datvo10-design/Single-Cycle-Pipelined-RISC-V-Processor/README.md

# Single-Cycle-Pipelined-RISC-V-Processor
Single-Cycle &amp; Pipelined RISC-V Processor
