datvo10-design/Single-Cycle-Pipelined-RISC-V-Processor/(list of files, drawings)

Other design files:
03_sim/wave.dsn
