datvo10-design/Single-Cycle-Pipelined-RISC-V-Processor/00_src/primitive/sll_32bit.sv

// --- Module chính: Bộ dịch trái 32-bit bằng cách ghép 32 con mux 32-1 1bit với nhau ---
module sll_32bit (
    input  logic [31:0] Y,		// dữ liệu 32 bit đưa vào
    input  logic [4:0] S,		// tín hiệu điều khiển, ví dụ S = sel = 00000 thì ngõ vào dữ liệu là d0
    output logic [31:0] Z		// dữ liệu 32 bit ra
);
		// Bắt đầu nối chân cho 32 con MUX
		// 1. MUX cho bit Z31: đây là trường hợp chưa dịch bit nào (Inputs: Y31, Y32,...Y1, Y0: tổng 32 ngõ vào
		mux_32_to_1 u_mux_for_Z32 (.d0(Y[31]), .d1(Y[30]), .d2(Y[29]), .d3(Y[28]), .d4(Y[27]), .d5(Y[26]), .d6(Y[25]), .d7(Y[24]),
                         .d8(Y[23]), .d9(Y[22]), .d10(Y[21]), .d11(Y[20]), .d12(Y[19]), .d13(Y[18]), .d14(Y[17]), .d15(Y[16]),
                         .d16(Y[15]), .d17(Y[14]), .d18(Y[13]), .d19(Y[12]), .d20(Y[11]), .d21(Y[10]), .d22(Y[9]), .d23(Y[8]),
                         .d24(Y[7]), .d25(Y[6]), .d26(Y[5]), .d27(Y[4]), .d28(Y[3]), .d29(Y[2]), .d30(Y[1]), .d31(Y[0]), .sel(S), .Z(Z[31]));
								 
		// 2. MUX cho bit Z30 (Inputs: Y30, Y29, ..., Y0, 0)
		mux_32_to_1 u_mux_for_Z30 (.d0(Y[30]), .d1(Y[29]), .d2(Y[28]), .d3(Y[27]), .d4(Y[26]), .d5(Y[25]), .d6(Y[24]), .d7(Y[23]),
                         .d8(Y[22]), .d9(Y[21]), .d10(Y[20]), .d11(Y[19]), .d12(Y[18]), .d13(Y[17]), .d14(Y[16]), .d15(Y[15]),
                         .d16(Y[14]), .d17(Y[13]), .d18(Y[12]), .d19(Y[11]), .d20(Y[10]), .d21(Y[9]),  .d22(Y[8]),  .d23(Y[7]),
                         .d24(Y[6]),  .d25(Y[5]),  .d26(Y[4]),  .d27(Y[3]),  .d28(Y[2]),  .d29(Y[1]),  .d30(Y[0]),  .d31(1'b0), .sel(S), .Z(Z[30]));	

		// 3. MUX cho bit Z29
		mux_32_to_1 u_mux_for_Z29 (.d0(Y[29]), .d1(Y[28]), .d2(Y[27]), .d3(Y[26]), .d4(Y[25]), .d5(Y[24]), .d6(Y[23]), .d7(Y[22]),
                         .d8(Y[21]), .d9(Y[20]), .d10(Y[19]), .d11(Y[18]), .d12(Y[17]), .d13(Y[16]), .d14(Y[15]), .d15(Y[14]),
                         .d16(Y[13]), .d17(Y[12]), .d18(Y[11]), .d19(Y[10]), .d20(Y[9]),  .d21(Y[8]),  .d22(Y[7]),  .d23(Y[6]),
                         .d24(Y[5]),  .d25(Y[4]),  .d26(Y[3]),  .d27(Y[2]),  .d28(Y[1]),  .d29(Y[0]),  .d30(1'b0), .d31(1'b0), .sel(S), .Z(Z[29]));

		// 4. MUX cho bit Z28
		mux_32_to_1 u_mux_for_Z28 (.d0(Y[28]), .d1(Y[27]), .d2(Y[26]), .d3(Y[25]), .d4(Y[24]), .d5(Y[23]), .d6(Y[22]), .d7(Y[21]),
                         .d8(Y[20]), .d9(Y[19]), .d10(Y[18]), .d11(Y[17]), .d12(Y[16]), .d13(Y[15]), .d14(Y[14]), .d15(Y[13]),
                         .d16(Y[12]), .d17(Y[11]), .d18(Y[10]), .d19(Y[9]),  .d20(Y[8]),  .d21(Y[7]),  .d22(Y[6]),  .d23(Y[5]),
                         .d24(Y[4]),  .d25(Y[3]),  .d26(Y[2]),  .d27(Y[1]),  .d28(Y[0]),  .d29(1'b0), .d30(1'b0), .d31(1'b0), .sel(S), .Z(Z[28]));

		// 5. MUX cho bit Z27
		mux_32_to_1 u_mux_for_Z27 (.d0(Y[27]), .d1(Y[26]), .d2(Y[25]), .d3(Y[24]), .d4(Y[23]), .d5(Y[22]), .d6(Y[21]), .d7(Y[20]),
                         .d8(Y[19]), .d9(Y[18]), .d10(Y[17]), .d11(Y[16]), .d12(Y[15]), .d13(Y[14]), .d14(Y[13]), .d15(Y[12]),
                         .d16(Y[11]), .d17(Y[10]), .d18(Y[9]),  .d19(Y[8]),  .d20(Y[7]),  .d21(Y[6]),  .d22(Y[5]),  .d23(Y[4]),
                         .d24(Y[3]),  .d25(Y[2]),  .d26(Y[1]),  .d27(Y[0]),  .d28(1'b0), .d29(1'b0), .d30(1'b0), .d31(1'b0), .sel(S), .Z(Z[27]));

		// 6. MUX cho bit Z26
		mux_32_to_1 u_mux_for_Z26 (.d0(Y[26]), .d1(Y[25]), .d2(Y[24]), .d3(Y[23]), .d4(Y[22]), .d5(Y[21]), .d6(Y[20]), .d7(Y[19]),
                         .d8(Y[18]), .d9(Y[17]), .d10(Y[16]), .d11(Y[15]), .d12(Y[14]), .d13(Y[13]), .d14(Y[12]), .d15(Y[11]),
                         .d16(Y[10]), .d17(Y[9]),  .d18(Y[8]),  .d19(Y[7]),  .d20(Y[6]),  .d21(Y[5]),  .d22(Y[4]),  .d23(Y[3]),
                         .d24(Y[2]),  .d25(Y[1]),  .d26(Y[0]),  .d27(1'b0), .d28(1'b0), .d29(1'b0), .d30(1'b0), .d31(1'b0), .sel(S), .Z(Z[26]));

		// 7. MUX cho bit Z25
		mux_32_to_1 u_mux_for_Z25 (.d0(Y[25]), .d1(Y[24]), .d2(Y[23]), .d3(Y[22]), .d4(Y[21]), .d5(Y[20]), .d6(Y[19]), .d7(Y[18]),
                         .d8(Y[17]), .d9(Y[16]), .d10(Y[15]), .d11(Y[14]), .d12(Y[13]), .d13(Y[12]), .d14(Y[11]), .d15(Y[10]),
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
                         .d16(1'b0), .d17(1'b0), .d18(1'b0), .d19(1'b0), .d20(1'b0), .d21(1'b0), .d22(1'b0), .d23(1'b0),
                         .d24(1'b0), .d25(1'b0), .d26(1'b0), .d27(1'b0), .d28(1'b0), .d29(1'b0), .d30(1'b0), .d31(1'b0), .sel(S), .Z(Z[0]));
		
endmodule
