datvo10-design/Single-Cycle-Pipelined-RISC-V-Processor/00_src/primitive/sra_32bit.sv

// --- Module chính: Bộ dịch phải 32-bit bằng cách ghép 32 con mux 32-1 1bit với nhau ---
module sra_32bit (
    input  logic [31:0] Y,		// dữ liệu 32 bit đưa vào
    input  logic [4:0] S,		// tín hiệu điều khiển, ví dụ S = sel = 00000 thì ngõ vào dữ liệu là d0
    output logic [31:0] Z		// dữ liệu 32 bit ra
);
		// Bắt đầu nối chân cho 32 con MUX
		// 1. MUX cho bit Z31 (Inputs: Y31, Y31, Y31,...Y31): tổng 32 ngõ vào
		mux_32_to_1 u_mux_for_Z32 (.d0(Y[31]), .d1(Y[31]), .d2(Y[31]), .d3(Y[31]), .d4(Y[31]), .d5(Y[31]), .d6(Y[31]), .d7(Y[31]), .d8(Y[31]), 
						.d9(Y[31]), .d10(Y[31]), .d11(Y[31]), .d12(Y[31]), .d13(Y[31]), .d14(Y[31]), .d15(Y[31]), .d16(Y[31]), 
						.d17(Y[31]), .d18(Y[31]), .d19(Y[31]), .d20(Y[31]), .d21(Y[31]), .d22(Y[31]), .d23(Y[31]), .d24(Y[31]),
						.d25(Y[31]), .d26(Y[31]), .d27(Y[31]), .d28(Y[31]), .d29(Y[31]), .d30(Y[31]), .d31(Y[31]), .sel(S), .Z(Z[31]));
											

		// 2. MUX cho bit Z30 (Inputs: Y30, Y31, Y31, Y31...)
		mux_32_to_1 u_mux_for_Z30 (.d0(Y[30]), .d1(Y[31]), .d2(Y[31]), .d3(Y[31]), .d4(Y[31]), .d5(Y[31]), .d6(Y[31]), .d7(Y[31]),
                         .d8(Y[31]), .d9(Y[31]), .d10(Y[31]), .d11(Y[31]), .d12(Y[31]), .d13(Y[31]), .d14(Y[31]), .d15(Y[31]),
                         .d16(Y[31]), .d17(Y[31]), .d18(Y[31]), .d19(Y[31]), .d20(Y[31]), .d21(Y[31]), .d22(Y[31]), .d23(Y[31]),
                         .d24(Y[31]), .d25(Y[31]), .d26(Y[31]), .d27(Y[31]), .d28(Y[31]), .d29(Y[31]), .d30(Y[31]), .d31(Y[31]), .sel(S), .Z(Z[30]));	

		// 3. MUX cho bit Z29
		mux_32_to_1 u_mux_for_Z29 (.d0(Y[29]), .d1(Y[30]), .d2(Y[31]), .d3(Y[31]), .d4(Y[31]), .d5(Y[31]), .d6(Y[31]), .d7(Y[31]),
                         .d8(Y[31]), .d9(Y[31]), .d10(Y[31]), .d11(Y[31]), .d12(Y[31]), .d13(Y[31]), .d14(Y[31]), .d15(Y[31]),
                         .d16(Y[31]), .d17(Y[31]), .d18(Y[31]), .d19(Y[31]), .d20(Y[31]), .d21(Y[31]), .d22(Y[31]), .d23(Y[31]),
                         .d24(Y[31]), .d25(Y[31]), .d26(Y[31]), .d27(Y[31]), .d28(Y[31]), .d29(Y[31]), .d30(Y[31]), .d31(Y[31]), .sel(S), .Z(Z[29]));

		// 4. MUX cho bit Z28
		mux_32_to_1 u_mux_for_Z28 (.d0(Y[28]), .d1(Y[29]), .d2(Y[30]), .d3(Y[31]), .d4(Y[31]), .d5(Y[31]), .d6(Y[31]), .d7(Y[31]),
                         .d8(Y[31]), .d9(Y[31]), .d10(Y[31]), .d11(Y[31]), .d12(Y[31]), .d13(Y[31]), .d14(Y[31]), .d15(Y[31]),
                         .d16(Y[31]), .d17(Y[31]), .d18(Y[31]), .d19(Y[31]), .d20(Y[31]), .d21(Y[31]), .d22(Y[31]), .d23(Y[31]),
                         .d24(Y[31]), .d25(Y[31]), .d26(Y[31]), .d27(Y[31]), .d28(Y[31]), .d29(Y[31]), .d30(Y[31]), .d31(Y[31]), .sel(S), .Z(Z[28]));

		// 5. MUX cho bit Z27
		mux_32_to_1 u_mux_for_Z27 (.d0(Y[27]), .d1(Y[28]), .d2(Y[29]), .d3(Y[30]), .d4(Y[31]), .d5(Y[31]), .d6(Y[31]), .d7(Y[31]),
                         .d8(Y[31]), .d9(Y[31]), .d10(Y[31]), .d11(Y[31]), .d12(Y[31]), .d13(Y[31]), .d14(Y[31]), .d15(Y[31]),
                         .d16(Y[31]), .d17(Y[31]), .d18(Y[31]), .d19(Y[31]), .d20(Y[31]), .d21(Y[31]), .d22(Y[31]), .d23(Y[31]),
                         .d24(Y[31]), .d25(Y[31]), .d26(Y[31]), .d27(Y[31]), .d28(Y[31]), .d29(Y[31]), .d30(Y[31]), .d31(Y[31]), .sel(S), .Z(Z[27]));

		// 6. MUX cho bit Z26
		mux_32_to_1 u_mux_for_Z26 (.d0(Y[26]), .d1(Y[27]), .d2(Y[28]), .d3(Y[29]), .d4(Y[30]), .d5(Y[31]), .d6(Y[31]), .d7(Y[31]),
                         .d8(Y[31]), .d9(Y[31]), .d10(Y[31]), .d11(Y[31]), .d12(Y[31]), .d13(Y[31]), .d14(Y[31]), .d15(Y[31]),
                         .d16(Y[31]), .d17(Y[31]), .d18(Y[31]), .d19(Y[31]), .d20(Y[31]), .d21(Y[31]), .d22(Y[31]), .d23(Y[31]),
                         .d24(Y[31]), .d25(Y[31]), .d26(Y[31]), .d27(Y[31]), .d28(Y[31]), .d29(Y[31]), .d30(Y[31]), .d31(Y[31]), .sel(S), .Z(Z[26]));

		// 7. MUX cho bit Z25
		mux_32_to_1 u_mux_for_Z25 (.d0(Y[25]), .d1(Y[26]), .d2(Y[27]), .d3(Y[28]), .d4(Y[29]), .d5(Y[30]), .d6(Y[31]), .d7(Y[31]),
                         .d8(Y[31]), .d9(Y[31]), .d10(Y[31]), .d11(Y[31]), .d12(Y[31]), .d13(Y[31]), .d14(Y[31]), .d15(Y[31]),
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
                        .d16(Y[19]), .d17(Y[20]), .d18(Y[21]), .d19(Y[22]), .d20(Y[23]), .d21(Y[24]), .d22(Y[25]), .d23(Y[26]),
                        .d24(Y[27]), .d25(Y[28]), .d26(Y[29]), .d27(Y[30]), .d28(Y[31]), .d29(Y[31]), .d30(Y[31]), .d31(Y[31]), .sel(S), .Z(Z[3]));

		// 30. MUX cho bit Z2
		mux_32_to_1 u_mux_for_Z2 (.d0(Y[2]), .d1(Y[3]), .d2(Y[4]), .d3(Y[5]), .d4(Y[6]), .d5(Y[7]), .d6(Y[8]), .d7(Y[9]),
                        .d8(Y[10]), .d9(Y[11]), .d10(Y[12]), .d11(Y[13]), .d12(Y[14]), .d13(Y[15]), .d14(Y[16]), .d15(Y[17]),
                        .d16(Y[18]), .d17(Y[19]), .d18(Y[20]), .d19(Y[21]), .d20(Y[22]), .d21(Y[23]), .d22(Y[24]), .d23(Y[25]),
                        .d24(Y[26]), .d25(Y[27]), .d26(Y[28]), .d27(Y[29]), .d28(Y[30]), .d29(Y[31]), .d30(Y[31]), .d31(Y[31]), .sel(S), .Z(Z[2]));

		// 31. MUX cho bit Z1
		mux_32_to_1 u_mux_for_Z1 (.d0(Y[1]), .d1(Y[2]), .d2(Y[3]), .d3(Y[4]), .d4(Y[5]), .d5(Y[6]), .d6(Y[7]), .d7(Y[8]), .d8(Y[9]),
                        .d9(Y[10]), .d10(Y[11]), .d11(Y[12]), .d12(Y[13]), .d13(Y[14]), .d14(Y[15]), .d15(Y[16]), .d16(Y[17]),
                        .d17(Y[18]), .d18(Y[19]), .d19(Y[20]), .d20(Y[21]), .d21(Y[22]), .d22(Y[23]), .d23(Y[24]), .d24(Y[25]),
                        .d25(Y[26]), .d26(Y[27]), .d27(Y[28]), .d28(Y[29]), .d29(Y[30]), .d30(Y[31]), .d31(Y[31]), .sel(S), .Z(Z[1]));

		// 32. MUX cho bit Z0
		mux_32_to_1 u_mux_for_Z0 (.d0(Y[0]), .d1(Y[1]), .d2(Y[2]), .d3(Y[3]), .d4(Y[4]), .d5(Y[5]), .d6(Y[6]), .d7(Y[7]),
                        .d8(Y[8]), .d9(Y[9]), .d10(Y[10]), .d11(Y[11]), .d12(Y[12]), .d13(Y[13]), .d14(Y[14]), .d15(Y[15]),
                        .d16(Y[16]), .d17(Y[17]), .d18(Y[18]), .d19(Y[19]), .d20(Y[20]), .d21(Y[21]), .d22(Y[22]), .d23(Y[23]),
                        .d24(Y[24]), .d25(Y[25]), .d26(Y[26]), .d27(Y[27]), .d28(Y[28]), .d29(Y[29]), .d30(Y[30]), .d31(Y[31]), .sel(S), .Z(Z[0]));
		
endmodule: sra_32bit
